LattePandaTeam/LattePanda-Mu-Ultra/Electricals/README.md

# Electronic Design Resources

## Files

- Examples: official carrier board projects

- Libraries: Symbol and footprint libraries for LattePanda Mu Ultra

- Pinouts: All pin definitions for LattePanda Mu Ultra
