LattePandaTeam/LattePanda-Mu-Ultra/Electricals/Examples/README.md

# Sample Projects

LattePanda Mu / Mu Ultra carrier board sample projects for engineers' reference, designed with KiCAD. Please open with KiCAD version 9.0 or higher.

## Official Carrier Board Projects

The official carrier board examples for the LattePanda Mu Ultra are shared with those for the LattePanda Mu. 

Please visit: 👉 [**LattePanda-Mu/Examples**](https://github.com/LattePandaTeam/LattePanda-Mu/tree/main/Electricals/Examples)
