LattePandaTeam/LattePanda-Mu-Ultra/Electricals/Pinouts/LattePanda_Mu_and_Mu_Ultra_Pinout_Comparison.xlsx

Sheet: Overview
 | This document compares the edge connector pins of the LattePanda Mu and LattePanda Mu Ultra to facilitate migration evaluation for your carrier board design.
 | 1. The pin definitions of the LattePanda Mu and LattePanda Mu Ultra are slightly different, and we have used color coding to make it easier for you to compare and evaluate them.
Pin Color Coding Legend
Colour | Note
 | Green (Fully Compatible): Matching voltage level and pin function.
 | Light Green (Conditionally Compatible): Matching voltage level; Pin function varies based on pin muxing or default BIOS config.
 | White (Modified Specification): Changes in pin function or voltage level, within safe limits.
 | Yellow (High Risk): Voltage level mismatch; requires special attention and procedures to prevent pin damage!
 | Special attention and procesures must be paid to Yellow-highlighted pins when designing custom carrier boards!
 | 2. The multiplexing and bifurcation of the high-speed ports on the LattePanda Mu and LattePanda Mu Ultra are different, as shown in the following two figures.
LattePanda Mu |  |  |  |  | LattePanda Mu Ultra
 | 3. The following USB 2.0 ports are bound to TCP ports in the default BIOS firmware.
 | LattePanda Mu |  |  | LattePanda Mu Ultra
 | Pin No. | Signal Name | Note | Pin No. | Signal Name | Note
 | 112 | USB2_P6_P (TCP1) | Must be used with TCP1; cannot be used as generic USB 2.0 | 112 | USB2_P2_P (TCP0) | can be used as generic USB 2.0
 | 114 | USB2_P6_N (TCP1) |  | 114 | USB2_P2_N (TCP0)
 |  |  |  | 109 | USB2_P1_N (TCP1) | can be used as generic USB 2.0
 |  |  |  | 111 | USB2_P1_P (TCP1)
 | 4. If you are using an M.2 CNVio wireless module(e.g. Intel AX211), you must use the USB2_P6 port for Bluetooth. USB2_P6 can also be used as a general-purpose USB 2.0 port.
 |  |  |  | LattePanda Mu Ultra
 |  |  |  | Pin No. | Signal Name
 |  |  |  | 82 | USB2_P6_P (BT)
 |  |  |  | 84 | USB2_P6_N (BT)

Sheet: Front
Pin | LattePana Mu |  |  | LattePanda Mu Ultra
 | Signal Name | Direction | IO Level | Signal Name | Direction | IO Level
1 | PWR_SW# | I | 3.3V | PWR_SW# | I | 3.3V
3 | RST_SW# | I | 3.3V | RST_SW# | I | 3.3V
5 | PSON | O | 3.3V | SLP_S0_S3 | O | 3.3V
7 | SLP_S4 | O | 3.3V | SLP_S4 | O | 3.3V
9 | TSENSE | I | 3.3V | TSENSE | I | 3.3V
11 | GND | PWR | 0V | GND | PWR | 0V
13 | HSIO0_TX_P | O | 0.8V | USB3_P1_TX_P | O | 0.8V
15 | HSIO0_TX_N | O | 0.8V | USB3_P1_TX_N | O | 0.8V
17 | GND | PWR | 0V | GND | PWR | 0V
19 | HSIO1_TX_P | O | 0.8V | USB3_P2_TX_P | O | 0.8V
21 | HSIO1_TX_N | O | 0.8V | USB3_P2_TX_N | O | 0.8V
23 | GND | PWR | 0V | GND | PWR | 0V
25 | HSIO2_TX_P | O | 0.8V | PCIE_TX3_P | O | 0.8V
27 | HSIO2_TX_N | O | 0.8V | PCIE_TX3_N | O | 0.8V
29 | GND | PWR | 0V | GND | PWR | 0V
31 | HSIO3_TX_P | O | 0.8V | PCIE_TX4_P | O | 0.8V
33 | HSIO3_TX_N | O | 0.8V | PCIE_TX4_N | O | 0.8V
35 | GND | PWR | 0V | GND | PWR | 0V
37 | HSIO8_TX_P | O | 0.8V | PCIE_TX5_P | O | 0.8V
39 | HSIO8_TX_N | O | 0.8V | PCIE_TX5_N | O | 0.8V
41 | GND | PWR | 0V | GND | PWR | 0V
43 | HSIO9_TX_P | O | 0.8V | PCIE_TX6_P | O | 0.8V
45 | HSIO9_TX_N | O | 0.8V | PCIE_TX6_N | O | 0.8V
47 | GND | PWR | 0V | GND | PWR | 0V
49 | HSIO10_TX_P | O | 0.8V | PCIE_TX7_P | O | 0.8V
51 | HSIO10_TX_N | O | 0.8V | PCIE_TX7_N | O | 0.8V
53 | GND | PWR | 0V | GND | PWR | 0V
55 | HSIO11_TX_P | O | 0.8V | PCIE_TX8_P | O | 0.8V
57 | HSIO11_TX_N | O | 0.8V | PCIE_TX8_N | O | 0.8V
59 | GND | PWR | 0V | GND | PWR | 0V
61 | HSIO6_TX_P | O | 0.8V | PCIE_TX1_P | O | 0.8V
63 | HSIO6_TX_N | O | 0.8V | PCIE_TX1_N | O | 0.8V
65 | GND | PWR | 0V | GND | PWR | 0V
67 | USB2_P1_N | I/O | 3.3V | PCIE_TX2_P | O | 0.8V
69 | USB2_P1_P | I/O | 3.3V | PCIE_TX2_N | O | 0.8V
71 | GND | PWR | 0V | GND | PWR | 0V
73 | USB2_P2_N | I/O | 3.3V | USB2_P3_N | I/O | 3.3V
75 | USB2_P2_P | I/O | 3.3V | USB2_P3_P | I/O | 3.3V
77 | GND | PWR | 0V | GND | PWR | 0V
79 | USB2_P3_N | I/O | 3.3V | USB2_P4_N | I/O | 3.3V
81 | USB2_P3_P | I/O | 3.3V | USB2_P4_P | I/O | 3.3V
83 | GND | PWR | 0V | GND | PWR | 0V
85 | REFCLK0_P | O | 0.8V | REFCLK0_P | O | 0.8V
87 | REFCLK0_N | O | 0.8V | REFCLK0_N | O | 0.8V
89 | GND | PWR | 0V | GND | PWR | 0V
91 | REFCLK1_P | O | 0.8V | REFCLK1_P | O | 0.8V
93 | REFCLK1_N | O | 0.8V | REFCLK1_N | O | 0.8V
95 | GND | PWR | 0V | GND | PWR | 0V
97 | REFCLK2_P | O | 0.8V | REFCLK2_P | O | 0.8V
99 | REFCLK2_N | O | 0.8V | REFCLK2_N | O | 0.8V
101 | GND | PWR | 0V | GND | PWR | 0V
103 | PCIE_WAKE# | I | 3.3V | PCIE_WAKE# | I | 3.3V
105 | PLT_RST# | O | 3.3V | PLT_RST# | O | 3.3V
107 | GND | PWR | 0V | GND | PWR | 0V
109 | USB2_P5_N | I/O | 3.3V | USB2_P1_N (TCP1) | I/O | 3.3V
111 | USB2_P5_P | I/O | 3.3V | USB2_P1_P (TCP1) | I/O | 3.3V
113 | GND | PWR | 0V | GND | PWR | 0V
115 | VBAT | PWR | 3.0V | VBAT | PWR | 3.0V
117 | PROCHOT# | I | 3.3V | PROCHOT# | I | 3.3V
119 | GPP_E0 | I/O | 3.3V | GPP_E22 (8851_INT) | I/O | 1.8V
121 | GPP_A12 | I/O | 3.3V | CRF_CLKREQ | O | 1.8V
123 | SATA_LED# | O | 3.3V | CNV_RF_RESET# | I/O | 1.8V
125 | PMCALERT# | I | 3.3V | PMCALERT# | I | 3.3V
127 | TPM_IRQ | I | 3.3V | TPM_IRQ | I | 1.8V
129 | USB_OC# | I | 3.3V | USB_OC# | I | 3.3V
131 | SUSCLK | O | 3.3V | SUSCLK | O | 1.8V
133 | BIOS_SEL | I | 3.3V | BIOS_SEL# | I | 3.3V
135 | GND | PWR | 0V | GND | PWR | 0V
137 | UART0_RXD / GPP_H10 | I/O | 3.3V | UART0_RXD / GPP_H08 | I/O | 1.8V
139 | UART0_TXD / GPP_H11 | I/O | 3.3V | UART0_TXD / GPP_H09 | I/O | 1.8V
141 | UART1_RXD / GPP_D17 | I/O | 3.3V | UART1_RXD / GPP_H06 | I/O | 1.8V
143 | UART1_TXD / GPP_D18 | I/O | 3.3V | UART1_TXD / GPP_H07 | I/O | 1.8V
KEY
145 | SML1_DATA | I/O | 3.3V | SML1_DATA | I/O | 3.3V
147 | SML1_CLK | O | 3.3V | SML1_CLK | O | 3.3V
149 | SML1_ALERT# | I | 3.3V | RSVD | / | /
151 | GND | PWR | 0V | GND | PWR | 0V
153 | SPI_IO3 | I/O | 3.3V | SPI_IO3 | I/O | 1.8V
155 | SPI_CLK | O | 3.3V | SPI_CLK | O | 1.8V
157 | SPI_CS2# | O | 3.3V | TPM_SPI_CS# | O | 1.8V
159 | SPI_MOSI/SPI_IO0 | I/O | 3.3V | SPI_MOSI/SPI_IO0 | I/O | 1.8V
161 | SPI_IO2 | I/O | 3.3V | SPI_IO2 | I/O | 1.8V
163 | SPI_MISO/SPI_IO1 | I/O | 3.3V | SPI_MISO/SPI_IO1 | I/O | 1.8V
165 | SPI_CS# | O | 3.3V | FLASH_SPI_CS# | O | 1.8V
167 | GND | PWR | 0V | GND | PWR | 0V
169 | DDIB_CTRL_DATA | I/O | 3.3V | TCP2_CTRL_DATA | I/O | 3.3V
171 | DDIB_CTRL_CLK | O | 3.3V | TCP2_CTRL_CLK | O | 3.3V
173 | TCP1_CTRL_DATA | I/O | 3.3V | TCP1_CTRL_DATA | I/O | 3.3V
175 | TCP1_CTRL_CLK | O | 3.3V | TCP1_CTRL_CLK | O | 3.3V
177 | TCP0_CTRL_DATA | I/O | 3.3V | TCP0_CTRL_DATA | I/O | 3.3V
179 | TCP0_CTRL_CLK | O | 3.3V | TCP0_CTRL_CLK | O | 3.3V
181 | GND | PWR | 0V | GND | PWR | 0V
183 | DDIB_HPD | I | 3.3V | TCP2_HPD | I | 3.3V
185 | TCP1_HPD | I | 3.3V | TCP1_HPD | I | 3.3V
187 | TCP0_HPD | I | 3.3V | TCP0_HPD | I | 3.3V
189 | GND | PWR | 0V | GND | PWR | 0V
191 | DDIB_AUX_N | I/O | 0.6V | TCP2_AUX_N | I/O | 0.6V
193 | DDIB_AUX_P | I/O | 0.6V | TCP2_AUX_P | I/O | 0.6V
195 | GND | PWR | 0V | GND | PWR | 0V
197 | DDIB_TX3_N | O | 1.2V | TCP2_TXRX1_N | I/O | 1.2V
199 | DDIB_TX3_P | O | 1.2V | TCP2_TXRX1_P | I/O | 1.2V
201 | GND | PWR | 0V | GND | PWR | 0V
203 | DDIB_TX2_N | O | 1.2V | TCP2_TX1_N | O | 1.2V
205 | DDIB_TX2_P | O | 1.2V | TCP2_TX1_P | O | 1.2V
207 | GND | PWR | 0V | GND | PWR | 0V
209 | DDIB_TX1_N | O | 1.2V | TCP2_TXRX0_N | I/O | 1.2V
211 | DDIB_TX1_P | O | 1.2V | TCP2_TXRX0_P | I/O | 1.2V
213 | GND | PWR | 0V | GND | PWR | 0V
215 | DDIB_TX0_N | O | 1.2V | TCP2_TX0_N | O | 1.2V
217 | DDIB_TX0_P | O | 1.2V | TCP2_TX0_P | O | 1.2V
219 | GND | PWR | 0V | GND | PWR | 0V
221 | TCP0_AUX_N | I/O | 0.6V | TCP0_AUX_N | I/O | 0.6V
223 | TCP0_AUX_P | I/O | 0.6V | TCP0_AUX_P | I/O | 0.6V
225 | GND | PWR | 0V | GND | PWR | 0V
227 | TCP0_TXRX1_N | I/O | 1.2V | TCP0_TXRX1_N | I/O | 1.2V
229 | TCP0_TXRX1_P | I/O | 1.2V | TCP0_TXRX1_P | I/O | 1.2V
231 | GND | PWR | 0V | GND | PWR | 0V
233 | TCP0_TX1_N | O | 1.2V | TCP0_TX1_N | O | 1.2V
235 | TCP0_TX1_P | O | 1.2V | TCP0_TX1_P | O | 1.2V
237 | GND | PWR | 0V | GND | PWR | 0V
239 | TCP0_TXRX0_N | I/O | 1.2V | TCP0_TXRX0_N | I/O | 1.2V
241 | TCP0_TXRX0_P | I/O | 1.2V | TCP0_TXRX0_P | I/O | 1.2V
243 | GND | PWR | 0V | GND | PWR | 0V
245 | TCP0_TX0_N | O | 1.2V | TCP0_TX0_N | O | 1.2V
247 | TCP0_TX0_P | O | 1.2V | TCP0_TX0_P | O | 1.2V
249 | GND | PWR | 0V | GND | PWR | 0V
251 | VIN | PWR | 9V ~ 20V | VIN | PWR | 9V ~ 20V
253 | VIN | PWR | 9V ~ 20V | VIN | PWR | 9V ~ 20V
255 | VIN | PWR | 9V ~ 20V | VIN | PWR | 9V ~ 20V
257 | VIN | PWR | 9V ~ 20V | VIN | PWR | 9V ~ 20V
259 | VIN | PWR | 9V ~ 20V | VIN | PWR | 9V ~ 20V

Sheet: Back
Pin | LattePana Mu |  |  | LattePanda Mu Ultra
 | Signal Name | Direction | IO Level | Signal Name | Direction | IO Level
2 | FAN2_CTL | O | 3.3V | FAN2_CTL | O | 3.3V
4 | FAN2_TAC | I | 5V | FAN2_TAC | I | 5V
6 | FAN3_CTL | O | 3.3V | FAN3_CTL | O | 3.3V
8 | FAN3_TAC | I | 5V | FAN3_TAC | I | 5V
10 | SIO_UART_TX | O | 3.3V | SIO_UART_TX | O | 3.3V
12 | SIO_UART_RX | I | 3.3V | SIO_UART_RX | I | 3.3V
14 | GND | PWR | 0V | GND | PWR | 0V
16 | HSIO0_RX_P | I | 0.8V | USB3_P1_RX_P | I | 0.8V
18 | HSIO0_RX_N | I | 0.8V | USB3_P1_RX_N | I | 0.8V
20 | GND | PWR | 0V | GND | PWR | 0V
22 | HSIO1_RX_P | I | 0.8V | USB3_P2_RX_P | I | 0.8V
24 | HSIO1_RX_N | I | 0.8V | USB3_P2_RX_N | I | 0.8V
26 | GND | PWR | 0V | GND | PWR | 0V
28 | HSIO2_RX_P | I | 0.8V | PCIE_RX3_P | I | 0.8V
30 | HSIO2_RX_N | I | 0.8V | PCIE_RX3_N | I | 0.8V
32 | GND | PWR | 0V | GND | PWR | 0V
34 | HSIO3_RX_P | I | 0.8V | PCIE_RX4_P | I | 0.8V
36 | HSIO3_RX_N | I | 0.8V | PCIE_RX4_N | I | 0.8V
38 | GND | PWR | 0V | GND | PWR | 0V
40 | HSIO8_RX_P | I | 0.8V | PCIE_RX5_P | I | 0.8V
42 | HSIO8_RX_N | I | 0.8V | PCIE_RX5_N | I | 0.8V
44 | GND | PWR | 0V | GND | PWR | 0V
46 | HSIO9_RX_P | I | 0.8V | PCIE_RX6_P | I | 0.8V
48 | HSIO9_RX_N | I | 0.8V | PCIE_RX6_N | I | 0.8V
50 | GND | PWR | 0V | GND | PWR | 0V
52 | HSIO10_RX_P | I | 0.8V | PCIE_RX7_P | I | 0.8V
54 | HSIO10_RX_N | I | 0.8V | PCIE_RX7_N | I | 0.8V
56 | GND | PWR | 0V | GND | PWR | 0V
58 | HSIO11_RX_P | I | 0.8V | PCIE_RX8_P | I | 0.8V
60 | HSIO11_RX_N | I | 0.8V | PCIE_RX8_N | I | 0.8V
62 | GND | PWR | 0V | GND | PWR | 0V
64 | HSIO6_RX_P | I | 0.8V | PCIE_RX1_P | I | 0.8V
66 | HSIO6_RX_N | I | 0.8V | PCIE_RX1_N | I | 0.8V
68 | GND | PWR | 0V | GND | PWR | 0V
70 | USB2_P4_P | I/O | 3.3V | PCIE_RX2_P | I | 0.8V
72 | USB2_P4_N | I/O | 3.3V | PCIE_RX2_N | I | 0.8V
74 | GND | PWR | 0V | GND | PWR | 0V
76 | USB2_P7_P | I/O | 3.3V | USB2_P5_P | I/O | 3.3V
78 | USB2_P7_N | I/O | 3.3V | USB2_P5_N | I/O | 3.3V
80 | GND | PWR | 0V | GND | PWR | 0V
82 | USB2_P8_P | I/O | 3.3V | USB2_P6_P (BT) | I/O | 3.3V
84 | USB2_P8_N | I/O | 3.3V | USB2_P6_N (BT) | I/O | 3.3V
86 | GND | PWR | 0V | GND | PWR | 0V
88 | REFCLK3_P | O | 0.8V | REFCLK3_P | O | 0.8V
90 | REFCLK3_N | O | 0.8V | REFCLK3_N | O | 0.8V
92 | GND | PWR | 0V | GND | PWR | 0V
94 | REFCLK4_P | O | 0.8V | REFCLK4_P | O | 0.8V
96 | REFCLK4_N | O | 0.8V | REFCLK4_N | O | 0.8V
98 | GND | PWR | 0V | GND | PWR | 0V
100 | REFCLK_REQ3# | I | 3.3V | REFCLK_REQ3# | I | 3.3V
102 | REFCLK_REQ4# | I | 3.3V | REFCLK_REQ4# | I | 3.3V
104 | SMB_ALERT# | I | 3.3V | REFCLK_REQ0# | I | 3.3V
106 | SMB_CLK | O | 3.3V | REFCLK_REQ1# | I | 3.3V
108 | SMB_DATA | I/O | 3.3V | REFCLK_REQ2# | I | 3.3V
110 | GND | PWR | 0V | GND | PWR | 0V
112 | USB2_P6_P (TCP1) | I/O | 3.3V | USB2_P2_P (TCP0) | I/O | 3.3V
114 | USB2_P6_N (TCP1) | I/O | 3.3V | USB2_P2_N (TCP0) | I/O | 3.3V
116 | GND | PWR | 0V | GND | PWR | 0V
118 | GPP_F16 | I/O | 3.3V | GPP_E11 | I/O | 1.8V
120 | GPP_F15 | I/O | 3.3V | GPP_E14 | I/O | 1.8V
122 | GPP_F14 | I/O | 3.3V | GPP_E13 | I/O | 1.8V
124 | GPP_F13 | I/O | 3.3V | GPP_E17 | I/O | 1.8V
126 | GPP_F12 | I/O | 3.3V | GPP_E12 | I/O | 1.8V
128 | GPP_D0 | I/O | 3.3V | GPP_B04 | I/O | 1.8V
130 | GPP_D1 | I/O | 3.3V | GPP_B05 (8851_INT) | I/O | 1.8V
132 | GPP_D2 (8851_INT) | I/O | 3.3V | GPP_B06 | I/O | 1.8V
134 | GPP_D3 | I/O | 3.3V | GPP_B07 (BLINK) | I/O | 1.8V
136 | GND | PWR | 0V | RSVD | / | /
138 | SOC_UART2_TXD / GPP_F2 | I/O | 3.3V | CNV_RGI_DT | O | 1.8V
140 | SOC_UART2_RXD / GPP_F1 | I/O | 3.3V | CNV_BRI_RSP | I | 1.8V
142 | I2C5_SCL | O | 3.3V | CNV_BRI_DT | O | 1.8V
144 | I2C5_SDA | I/O | 3.3V | CNV_RGI_RSP | I | 1.8V
KEY
146 | I2C4_SCL | O | 3.3V | I2C3_SCL | O | 1.8V
148 | I2C4_SDA | I/O | 3.3V | I2C3_SDA | I/O | 1.8V
150 | I2C3_SCL | O | 3.3V | I2C2_SCL | O | 1.8V
152 | I2C3_SDA | I/O | 3.3V | I2C2_SDA | I/O | 1.8V
154 | I2C2_SCL (8851_I2C) | O | 3.3V | I2C1_SCL (8851_I2C) | O | 1.8V
156 | I2C2_SDA (8851_I2C) | I/O | 3.3V | I2C1_SDA (8851_I2C) | I/O | 1.8V
158 | GND | PWR | 0V | GND | PWR | 0V
160 | I2S_MCLK | O | 1.8V | RSVD | / | /
162 | I2S_SCLK | O | 1.8V | RSVD | / | /
164 | I2S_SFRM | O | 1.8V | RSVD | / | /
166 | I2S_TXD | O | 1.8V | RSVD | / | /
168 | I2S_RXD | I | 1.8V | RSVD | / | /
170 | GND | PWR | 0V | GND | PWR | 0V
172 | HDA_RST | O | 3.3V | HDA_RST# | O | 1.8V
174 | HDA_BCLK | O | 3.3V | HDA_BCLK | O | 1.8V
176 | HDA_SYNC | O | 3.3V | HDA_SYNC | O | 1.8V
178 | HDA_SDOUT | O | 3.3V | HDA_SDO | O | 1.8V
180 | HDA_SDIN | I | 3.3V | HDA_SDI0 | I | 1.8V
182 | GND | PWR | 0V | GND | PWR | 0V
184 | CSI_D_CK_P | I | 1.26V | CNV_WT_CLK_P | O | 1.2V
186 | CSI_D_CK_N | I | 1.26V | CNV_WT_CLK_N | O | 1.2V
188 | GND | PWR | 0V | GND | PWR | 0V
190 | CSI_D_D1_P | I | 1.26V | CNV_WT_D0_P | O | 1.2V
192 | CSI_D_D1_N | I | 1.26V | CNV_WT_D0_N | O | 1.2V
194 | GND | PWR | 0V | GND | PWR | 0V
196 | CSI_D_D0_P | I | 1.26V | CNV_WT_D1_P | O | 1.2V
198 | CSI_D_D0_N | I | 1.26V | CNV_WT_D1_N | O | 1.2V
200 | GND | PWR | 0V | GND | PWR | 0V
202 | CSI_C_CK_P | I | 1.26V | CNV_WR_CLK_P | I | 1.2V
204 | CSI_C_CK_N | I | 1.26V | CNV_WR_CLK_N | I | 1.2V
206 | GND | PWR | 0V | GND | PWR | 0V
208 | CSI_C_D1_P | I | 1.26V | CNV_WR_D0_P | I | 1.2V
210 | CSI_C_D1_N | I | 1.26V | CNV_WR_D0_N | I | 1.2V
212 | GND | PWR | 0V | GND | PWR | 0V
214 | CSI_C_D0_P | I | 1.26V | CNV_WR_D1_P | I | 1.2V
216 | CSI_C_D0_N | I | 1.26V | CNV_WR_D1_N | I | 1.2V
218 | GND | PWR | 0V | GND | PWR | 0V
220 | TCP1_TX0_P | O | 1.2V | TCP1_TX0_P | O | 1.2V
222 | TCP1_TX0_N | O | 1.2V | TCP1_TX0_N | O | 1.2V
224 | GND | PWR | 0V | GND | PWR | 0V
226 | TCP1_TXRX0_P | I/O | 1.2V | TCP1_TXRX0_P | I/O | 1.2V
228 | TCP1_TXRX0_N | I/O | 1.2V | TCP1_TXRX0_N | I/O | 1.2V
230 | GND | PWR | 0V | GND | PWR | 0V
232 | TCP1_TX1_P | O | 1.2V | TCP1_TX1_P | O | 1.2V
234 | TCP1_TX1_N | O | 1.2V | TCP1_TX1_N | O | 1.2V
236 | GND | PWR | 0V | GND | PWR | 0V
238 | TCP1_TXRX1_P | I/O | 1.2V | TCP1_TXRX1_P | I/O | 1.2V
240 | TCP1_TXRX1_N | I/O | 1.2V | TCP1_TXRX1_N | I/O | 1.2V
242 | GND | PWR | 0V | GND | PWR | 0V
244 | TCP1_AUX_P | I/O | 0.6V | TCP1_AUX_P | I/O | 0.6V
246 | TCP1_AUX_N | I/O | 0.6V | TCP1_AUX_N | I/O | 0.6V
248 | GND | PWR | 0V | GND | PWR | 0V
250 | VIN | PWR | 9V ~ 20V | VIN | PWR | 9V ~ 20V
252 | VIN | PWR | 9V ~ 20V | VIN | PWR | 9V ~ 20V
254 | VIN | PWR | 9V ~ 20V | VIN | PWR | 9V ~ 20V
256 | VIN | PWR | 9V ~ 20V | VIN | PWR | 9V ~ 20V
258 | VIN | PWR | 9V ~ 20V | VIN | PWR | 9V ~ 20V
260 | VIN | PWR | 9V ~ 20V | VIN | PWR | 9V ~ 20V
