LattePandaTeam/LattePanda-Mu-Ultra/Electricals/Pinouts/LattePanda_Mu_Ultra_Edge_Connector_Pinout.xlsx

Sheet: Overview
Speed: Indicates the operating speed of the signal pin. "Low" denotes low-speed signals requiring only standard PCB routing. "High" denotes high-speed signals which mandate impedance matching in the PCB design.
IO Level: For multiplexed pins, the IO voltage level may vary depending on the configured function. This document specifies the maximum voltage supported by the pin.
Note:
This document is applicable only to LattePanda Mu Ultra compute modules equipped with Intel Core Ultra 2 Series processor(Lunar Lake).
Due to the various PCIe bifurcation, please consult the BIOS functionality documentation before beginning your design:
https://github.com/LattePandaTeam/LattePanda-Mu-Ultra/tree/main/Softwares/BIOS
Pinout Description Page
https://github.com/LattePandaTeam/LattePanda-Mu-Ultra/tree/main/Electricals/Pinouts

Sheet: Front
Pin | Signal Name | Direction | IO Level | Description | Speed | Notes
1 | PWR_SW# | I | 3.3V | System Power Switch | Low | Active LOW; Internally 10K Pulled Up
3 | RST_SW# | I | 3.3V | System Reset Switch | Low | Active LOW; Internally 10K Pulled Up
5 | SLP_S0_S3 | O | 3.3V | System Status | Low | Output HIGH only when Working and Modern Standby; 4.7K Pulled-up(Weak Drive of HIGH output)
7 | SLP_S4 | O | 3.3V | System Status | Low | Output HIGH only when Working and Modern Standby; 4.7K Pulled-up(Weak Drive of HIGH output)
9 | TSENSE | I | 3.3V | NTC Temperature Sensor | Low
11 | GND | PWR | 0V | Ground | /
13 | USB3_P1_TX_P | O | 0.8V | USB 3.2 Port 1 TX Differential Pair | High | External AC Coupling Capacitor Required
15 | USB3_P1_TX_N | O | 0.8V | USB 3.2 Port 1 TX Differential Pair | High | External AC Coupling Capacitor Required
17 | GND | PWR | 0V | Ground | /
19 | USB3_P2_TX_P | O | 0.8V | USB 3.2 Port 2 TX Differential Pair | High | External AC Coupling Capacitor Required
21 | USB3_P2_TX_N | O | 0.8V | USB 3.2 Port 2 TX Differential Pair | High | External AC Coupling Capacitor Required
23 | GND | PWR | 0V | Ground | /
25 | PCIE_TX3_P | O | 0.8V | PCIe Lane 3 TX Differential Pair | High | External AC Coupling Capacitor Required
27 | PCIE_TX3_N | O | 0.8V | PCIe Lane 3 TX Differential Pair | High | External AC Coupling Capacitor Required
29 | GND | PWR | 0V | Ground | /
31 | PCIE_TX4_P | O | 0.8V | PCIe Lane 4 TX Differential Pair | High | External AC Coupling Capacitor Required
33 | PCIE_TX4_N | O | 0.8V | PCIe Lane 4 TX Differential Pair | High | External AC Coupling Capacitor Required
35 | GND | PWR | 0V | Ground | /
37 | PCIE_TX5_P | O | 0.8V | PCIe Lane 5 TX Differential Pair | High | External AC Coupling Capacitor Required
39 | PCIE_TX5_N | O | 0.8V | PCIe Lane 5 TX Differential Pair | High | External AC Coupling Capacitor Required
41 | GND | PWR | 0V | Ground | /
43 | PCIE_TX6_P | O | 0.8V | PCIe Lane 6 TX Differential Pair | High | External AC Coupling Capacitor Required
45 | PCIE_TX6_N | O | 0.8V | PCIe Lane 6 TX Differential Pair | High | External AC Coupling Capacitor Required
47 | GND | PWR | 0V | Ground | /
49 | PCIE_TX7_P | O | 0.8V | PCIe Lane 7 TX Differential Pair | High | External AC Coupling Capacitor Required
51 | PCIE_TX7_N | O | 0.8V | PCIe Lane 7 TX Differential Pair | High | External AC Coupling Capacitor Required
53 | GND | PWR | 0V | Ground | /
55 | PCIE_TX8_P | O | 0.8V | PCIe Lane 8 TX Differential Pair | High | External AC Coupling Capacitor Required
57 | PCIE_TX8_N | O | 0.8V | PCIe Lane 8 TX Differential Pair | High | External AC Coupling Capacitor Required
59 | GND | PWR | 0V | Ground | /
61 | PCIE_TX1_P | O | 0.8V | PCIe Lane 1 TX Differential Pair | High | External AC Coupling Capacitor Required
63 | PCIE_TX1_N | O | 0.8V | PCIe Lane 1 TX Differential Pair | High | External AC Coupling Capacitor Required
65 | GND | PWR | 0V | Ground | /
67 | PCIE_TX2_P | O | 0.8V | PCIe Lane 2 TX Differential Pair | High | Integrated 220nF AC Coupling Capacitor
69 | PCIE_TX2_N | O | 0.8V | PCIe Lane 2 TX Differential Pair | High | Integrated 220nF AC Coupling Capacitor
71 | GND | PWR | 0V | Ground | /
73 | USB2_P3_N | I/O | 3.3V | USB 2.0 Port 3 Differential Pair | High
75 | USB2_P3_P | I/O | 3.3V | USB 2.0 Port 3 Differential Pair | High
77 | GND | PWR | 0V | Ground | /
79 | USB2_P4_N | I/O | 3.3V | USB 2.0 Port 4 Differential Pair | High
81 | USB2_P4_P | I/O | 3.3V | USB 2.0 Port 4 Differential Pair | High
83 | GND | PWR | 0V | Ground | /
85 | REFCLK0_P | O | 0.8V | PCIe Reference Clock 0 Differential Pair | High | 100MHz
87 | REFCLK0_N | O | 0.8V | PCIe Reference Clock 0 Differential Pair | High | 100MHz
89 | GND | PWR | 0V | Ground | /
91 | REFCLK1_P | O | 0.8V | PCIe Reference Clock 1 Differential Pair | High | 100MHz
93 | REFCLK1_N | O | 0.8V | PCIe Reference Clock 1 Differential Pair | High | 100MHz
95 | GND | PWR | 0V | Ground | /
97 | REFCLK2_P | O | 0.8V | PCIe Reference Clock 2 Differential Pair | High | 100MHz
99 | REFCLK2_N | O | 0.8V | PCIe Reference Clock 2 Differential Pair | High | 100MHz
101 | GND | PWR | 0V | Ground | /
103 | PCIE_WAKE# | I | 3.3V | PCIe Wake Request | Low | Pulled LOW to Wake System; Internally 10K Pulled Up
105 | PLT_RST# | O | 3.3V | Platform Reset for PCIe | Low | Output LOW to Reset PCIe Device
107 | GND | PWR | 0V | Ground | /
109 | USB2_P1_N | I/O | 3.3V | USB 2.0 Port 1 Differential Pair | High | Bound to TCP1 in Default BIOS
111 | USB2_P1_P | I/O | 3.3V | USB 2.0 Port 1 Differential Pair | High | Bound to TCP1 in Default BIOS
113 | GND | PWR | 0V | Ground | /
115 | VBAT | PWR | 3.0V | RTC Battery Input | /
117 | PROCHOT# | I | 3.3V | (TCC) Overheat Protect | Low | Active LOW; Internally 10K Pulled Up
119 | GPP_E22 | I/O | 1.8V | GPIO | Low | BIOS Default Function: IT8851_INT
121 | CRF_CLKREQ | O | 1.8V | CNVi SOC to CRF Wake Indication | Low
123 | CNV_RF_RESET# | I/O | 1.8V | CNVi RF Companion (CRF) Reset Signal | Low | Active Low
125 | PMCALERT# | I | 3.3V | USB Type-C PD Controller / Re-timer Alert | Low | Active LOW; Internally 10K Pulled Up
127 | TPM_IRQ | I | 1.8V | Discrete TPM Interrupt | Low | Internally 4.7K Pulled Up
129 | USB_OC# | I | 3.3V | USB Over Current | Low | Active LOW; Internally 10K Pulled Up
131 | SUSCLK | O | 1.8V | Suspend Clock | Low | 32.768KHz
133 | BIOS_SEL# | I | 3.3V | BIOS ROM Select | Low | Internally 100K Pulled Up; HIGH: Integrated ROM; LOW: Carrier ROM
135 | GND | PWR | 0V | Ground | /
137 | UART0_RXD / GPP_H08 | I/O | 1.8V | SoC UART0 RX / GPIO | Low | BIOS Default Function: UART
139 | UART0_TXD / GPP_H09 | I/O | 1.8V | SoC UART0 TX / GPIO | Low | BIOS Default Function: UART
141 | UART1_RXD / GPP_H06 | I/O | 1.8V | SoC UART1 RX / GPIO | Low | BIOS Default Function: UART
143 | UART1_TXD / GPP_H07 | I/O | 1.8V | SoC UART1 TX / GPIO | Low | BIOS Default Function: UART
KEY
145 | SML1_DATA | I/O | 3.3V | SMLink1 Data | Low | Internally 2.2K Pulled Up
147 | SML1_CLK | O | 3.3V | SMLink1 Clock | Low | Internally 2.2K Pulled Up
149 | RSVD | / | / | No Connect | /
151 | GND | PWR | 0V | Ground | /
153 | SPI_IO3 | I/O | 1.8V | SPI Bus for BIOS and dTPM | Low
155 | SPI_CLK | O | 1.8V | SPI Bus for BIOS and dTPM | Low
157 | TPM_SPI_CS# | O | 1.8V | SPI Chip Select for dTPM | Low
159 | SPI_MOSI/SPI_IO0 | I/O | 1.8V | SPI Bus for BIOS and dTPM | Low
161 | SPI_IO2 | I/O | 1.8V | SPI Bus for BIOS and dTPM | Low
163 | SPI_MISO/SPI_IO1 | I/O | 1.8V | SPI Bus for BIOS and dTPM | Low
165 | FLASH_SPI_CS# | O | 1.8V | SPI Chip Select for BIOS ROM | Low
167 | GND | PWR | 0V | Ground | /
169 | TCP2_CTRL_DATA | I/O | 3.3V | TCP2 Control Data | Low | Internally 4.7K Pulled Up
171 | TCP2_CTRL_CLK | O | 3.3V | TCP2 Control Clock | Low | Internally 4.7K Pulled Up
173 | TCP1_CTRL_DATA | I/O | 3.3V | TCP1 Control Data | Low | Internally 4.7K Pulled Up
175 | TCP1_CTRL_CLK | O | 3.3V | TCP1 Control Clock | Low | Internally 4.7K Pulled Up
177 | TCP0_CTRL_DATA | I/O | 3.3V | TCP0 Control Data | Low | Internally 4.7K Pulled Up
179 | TCP0_CTRL_CLK | O | 3.3V | TCP0 Control Clock | Low | Internally 4.7K Pulled Up
181 | GND | PWR | 0V | Ground | /
183 | TCP2_HPD | I | 3.3V | TCP2 Hot Plug Detect | Low
185 | TCP1_HPD | I | 3.3V | TCP1 Hot Plug Detect | Low
187 | TCP0_HPD | I | 3.3V | TCP0 Hot Plug Detect | Low
189 | GND | PWR | 0V | Ground | /
191 | TCP2_AUX_N | I/O | 0.6V | TCP2 DP Auxiliary Channel | Low
193 | TCP2_AUX_P | I/O | 0.6V | TCP2 DP Auxiliary Channel | Low
195 | GND | PWR | 0V | Ground | /
197 | TCP2_TXRX1_N | I/O | 1.2V | TCP2 DP Lane 3 / HDMI TMDS Clock / Type C RX Data Lane 2 | High | External AC Coupling Capacitor Required
199 | TCP2_TXRX1_P | I/O | 1.2V | TCP2 DP Lane 3 / HDMI TMDS Clock / Type C RX Data Lane 2 | High | External AC Coupling Capacitor Required
201 | GND | PWR | 0V | Ground | /
203 | TCP2_TX1_N | O | 1.2V | TCP2 DP Lane 2 / HDMI TMDS Data0 / Type C TX Data Lane 2 | High | External AC Coupling Capacitor Required
205 | TCP2_TX1_P | O | 1.2V | TCP2 DP Lane 2 / HDMI TMDS Data0 / Type C TX Data Lane 2 | High | External AC Coupling Capacitor Required
207 | GND | PWR | 0V | Ground | /
209 | TCP2_TXRX0_N | I/O | 1.2V | TCP2 DP Lane 1 / HDMI TMDS Data1 / Type C RX Data Lane 1 | High | External AC Coupling Capacitor Required
211 | TCP2_TXRX0_P | I/O | 1.2V | TCP2 DP Lane 1 / HDMI TMDS Data1 / Type C RX Data Lane 1 | High | External AC Coupling Capacitor Required
213 | GND | PWR | 0V | Ground | /
215 | TCP2_TX0_N | O | 1.2V | TCP2 DP Lane 0 / HDMI TMDS Data2 / Type C TX Data Lane 1 | High | External AC Coupling Capacitor Required
217 | TCP2_TX0_P | O | 1.2V | TCP2 DP Lane 0 / HDMI TMDS Data2 / Type C TX Data Lane 1 | High | External AC Coupling Capacitor Required
219 | GND | PWR | 0V | Ground | /
221 | TCP0_AUX_N | I/O | 0.6V | TCP0 DP Auxiliary Channel | Low
223 | TCP0_AUX_P | I/O | 0.6V | TCP0 DP Auxiliary Channel | Low
225 | GND | PWR | 0V | Ground | /
227 | TCP0_TXRX1_N | I/O | 1.2V | TCP0 DP Lane 3 / HDMI TMDS Clock / Type C RX Data Lane 2 | High | External AC Coupling Capacitor Required
229 | TCP0_TXRX1_P | I/O | 1.2V | TCP0 DP Lane 3 / HDMI TMDS Clock / Type C RX Data Lane 2 | High | External AC Coupling Capacitor Required
231 | GND | PWR | 0V | Ground | /
233 | TCP0_TX1_N | O | 1.2V | TCP0 DP Lane 2 / HDMI TMDS Data0 / Type C TX Data Lane 2 | High | External AC Coupling Capacitor Required
235 | TCP0_TX1_P | O | 1.2V | TCP0 DP Lane 2 / HDMI TMDS Data0 / Type C TX Data Lane 2 | High | External AC Coupling Capacitor Required
237 | GND | PWR | 0V | Ground | /
239 | TCP0_TXRX0_N | I/O | 1.2V | TCP0 DP Lane 1 / HDMI TMDS Data1 / Type C RX Data Lane 1 | High | External AC Coupling Capacitor Required
241 | TCP0_TXRX0_P | I/O | 1.2V | TCP0 DP Lane 1 / HDMI TMDS Data1 / Type C RX Data Lane 1 | High | External AC Coupling Capacitor Required
243 | GND | PWR | 0V | Ground | /
245 | TCP0_TX0_N | O | 1.2V | TCP0 DP Lane 0 / HDMI TMDS Data2 / Type C TX Data Lane 1 | High | External AC Coupling Capacitor Required
247 | TCP0_TX0_P | O | 1.2V | TCP0 DP Lane 0 / HDMI TMDS Data2 / Type C TX Data Lane 1 | High | External AC Coupling Capacitor Required
249 | GND | PWR | 0V | Ground | /
251 | VIN | PWR | 9V ~ 20V | Main Power Input | /
253 | VIN | PWR | 9V ~ 20V | Main Power Input | /
255 | VIN | PWR | 9V ~ 20V | Main Power Input | /
257 | VIN | PWR | 9V ~ 20V | Main Power Input | /
259 | VIN | PWR | 9V ~ 20V | Main Power Input | /

Sheet: Back
Pin | Signal Name | Direction | IO Level | Description | Speed | Notes
2 | FAN2_CTL | O | 3.3V | CPU Fan PWM | Low | Internally 4.7K Pulled Up
4 | FAN2_TAC | I | 5V | CPU Fan Tacho | Low
6 | FAN3_CTL | O | 3.3V | SYS Fan PWM | Low | Internally 4.7K Pulled Up
8 | FAN3_TAC | I | 5V | SYS Fan Tacho | Low
10 | SIO_UART_TX | O | 3.3V | SuperIO UART TX | Low
12 | SIO_UART_RX | I | 3.3V | SuperIO UART RX | Low
14 | GND | PWR | 0V | Ground | /
16 | USB3_P1_RX_P | I | 0.8V | USB 3.2 Port 1 RX Differential Pair | High | External AC Coupling Capacitor Required
18 | USB3_P1_RX_N | I | 0.8V | USB 3.2 Port 1 RX Differential Pair | High | External AC Coupling Capacitor Required
20 | GND | PWR | 0V | Ground | /
22 | USB3_P2_RX_P | I | 0.8V | USB 3.2 Port 2 RX Differential Pair | High | External AC Coupling Capacitor Required
24 | USB3_P2_RX_N | I | 0.8V | USB 3.2 Port 2 RX Differential Pair | High | External AC Coupling Capacitor Required
26 | GND | PWR | 0V | Ground | /
28 | PCIE_RX3_P | I | 0.8V | PCIe Lane 3 RX Differential Pair | High | External AC Coupling Capacitor Required
30 | PCIE_RX3_N | I | 0.8V | PCIe Lane 3 RX Differential Pair | High | External AC Coupling Capacitor Required
32 | GND | PWR | 0V | Ground | /
34 | PCIE_RX4_P | I | 0.8V | PCIe Lane 4 RX Differential Pair | High | External AC Coupling Capacitor Required
36 | PCIE_RX4_N | I | 0.8V | PCIe Lane 4 RX Differential Pair | High | External AC Coupling Capacitor Required
38 | GND | PWR | 0V | Ground | /
40 | PCIE_RX5_P | I | 0.8V | PCIe Lane 5 RX Differential Pair | High | External AC Coupling Capacitor Required
42 | PCIE_RX5_N | I | 0.8V | PCIe Lane 5 RX Differential Pair | High | External AC Coupling Capacitor Required
44 | GND | PWR | 0V | Ground | /
46 | PCIE_RX6_P | I | 0.8V | PCIe Lane 6 RX Differential Pair | High | External AC Coupling Capacitor Required
48 | PCIE_RX6_N | I | 0.8V | PCIe Lane 6 RX Differential Pair | High | External AC Coupling Capacitor Required
50 | GND | PWR | 0V | Ground | /
52 | PCIE_RX7_P | I | 0.8V | PCIe Lane 7 RX Differential Pair | High | External AC Coupling Capacitor Required
54 | PCIE_RX7_N | I | 0.8V | PCIe Lane 7 RX Differential Pair | High | External AC Coupling Capacitor Required
56 | GND | PWR | 0V | Ground | /
58 | PCIE_RX8_P | I | 0.8V | PCIe Lane 8 RX Differential Pair | High | External AC Coupling Capacitor Required
60 | PCIE_RX8_N | I | 0.8V | PCIe Lane 8 RX Differential Pair | High | External AC Coupling Capacitor Required
62 | GND | PWR | 0V | Ground | /
64 | PCIE_RX1_P | I | 0.8V | PCIe Lane 1 RX Differential Pair | High | External AC Coupling Capacitor Required
66 | PCIE_RX1_N | I | 0.8V | PCIe Lane 1 RX Differential Pair | High | External AC Coupling Capacitor Required
68 | GND | PWR | 0V | Ground | /
70 | PCIE_RX2_P | I | 0.8V | PCIe Lane 2 RX Differential Pair | High | Integrated 220nF AC Coupling Capacitor
72 | PCIE_RX2_N | I | 0.8V | PCIe Lane 2 RX Differential Pair | High | Integrated 220nF AC Coupling Capacitor
74 | GND | PWR | 0V | Ground | /
76 | USB2_P5_P | I/O | 3.3V | USB 2.0 Port 5 Differential Pair | High
78 | USB2_P5_N | I/O | 3.3V | USB 2.0 Port 5 Differential Pair | High
80 | GND | PWR | 0V | Ground | /
82 | USB2_P6_P | I/O | 3.3V | USB 2.0 Port 6 Differential Pair | High | Dedicated to BT; can also for generic USB 2.0
84 | USB2_P6_N | I/O | 3.3V | USB 2.0 Port 6 Differential Pair | High | Dedicated to BT; can also for generic USB 2.0
86 | GND | PWR | 0V | Ground | /
88 | REFCLK3_P | O | 0.8V | PCIe Reference Clock 3 Differential Pair | High | 100MHz
90 | REFCLK3_N | O | 0.8V | PCIe Reference Clock 3 Differential Pair | High | 100MHz
92 | GND | PWR | 0V | Ground | /
94 | REFCLK4_P | O | 0.8V | PCIe Reference Clock 4 Differential Pair | High | 100MHz
96 | REFCLK4_N | O | 0.8V | PCIe Reference Clock 4 Differential Pair | High | 100MHz
98 | GND | PWR | 0V | Ground | /
100 | REFCLK_REQ3# | I | 3.3V | Clock Request of REFCLK3 | Low | Active LOW; Internally 10K Pulled Up
102 | REFCLK_REQ4# | I | 3.3V | Clock Request of REFCLK4 | Low | Active LOW; Internally 10K Pulled Up
104 | REFCLK_REQ0# | I | 3.3V | Clock Request of REFCLK0 | Low | Active LOW; Internally 10K Pulled Up
106 | REFCLK_REQ1# | I | 3.3V | Clock Request of REFCLK1 | Low | Active LOW; Internally 10K Pulled Up
108 | REFCLK_REQ2# | I | 3.3V | Clock Request of REFCLK2 | Low | Active LOW; Internally 10K Pulled Up
110 | GND | PWR | 0V | Ground | /
112 | USB2_P2_P | I/O | 3.3V | USB 2.0 Port 2 Differential Pair | High | Bound to TCP0 in Default BIOS
114 | USB2_P2_N | I/O | 3.3V | USB 2.0 Port 2 Differential Pair | High | Bound to TCP0 in Default BIOS
116 | GND | PWR | 0V | Ground | /
118 | GPP_E11 | I/O | 1.8V | GPIO | Low
120 | GPP_E14 | I/O | 1.8V | GPIO | Low
122 | GPP_E13 | I/O | 1.8V | GPIO | Low
124 | GPP_E17 | I/O | 1.8V | GPIO | Low
126 | GPP_E12 | I/O | 1.8V | GPIO | Low
128 | GPP_B04 | I/O | 1.8V | GPIO | Low
130 | GPP_B05 | I/O | 1.8V | GPIO | Low | BIOS Default Function: IT8851_INT
132 | GPP_B06 | I/O | 1.8V | GPIO | Low
134 | GPP_B07 | I/O | 1.8V | GPIO | Low | BIOS Default Function: Modern Standby Blink Output
136 | RSVD | / | / | No Connect | /
138 | CNV_RGI_DT | O | 1.8V | CNVi RGI Bus TX | Low
140 | CNV_BRI_RSP | I | 1.8V | CNVi BRI Bus RX | Low
142 | CNV_BRI_DT | O | 1.8V | CNVi BRI Bus TX | Low
144 | CNV_RGI_RSP | I | 1.8V | CNVi RGI Bus RX | Low
KEY
146 | I2C3_SCL | O | 1.8V | I2C3 Clock | Low | Internally 2.2K Pulled Up
148 | I2C3_SDA | I/O | 1.8V | I2C3 Data | Low | Internally 2.2K Pulled Up
150 | I2C2_SCL | O | 1.8V | I2C2 Clock | Low | Internally 2.2K Pulled Up
152 | I2C2_SDA | I/O | 1.8V | I2C2 Data | Low | Internally 2.2K Pulled Up
154 | I2C1_SCL | O | 1.8V | I2C1 Clock | Low | Internally 2.2K Pulled Up
156 | I2C1_SDA | I/O | 1.8V | I2C1 Data | Low | Internally 2.2K Pulled Up
158 | GND | PWR | 0V | Ground | /
160 | RSVD | / | / | No Connect | /
162 | RSVD | / | / | No Connect | /
164 | RSVD | / | / | No Connect | /
166 | RSVD | / | / | No Connect | /
168 | RSVD | / | / | No Connect | /
170 | GND | PWR | 0V | Ground | /
172 | HDA_RST# | O | 1.8V | HD Audio Reset | Low
174 | HDA_BCLK | O | 1.8V | HD Audio Codec Bit Clock | Low
176 | HDA_SYNC | O | 1.8V | HD Audio Codec Sync | Low
178 | HDA_SDO | O | 1.8V | HD Audio Codec Serial Data Out | Low
180 | HDA_SDI0 | I | 1.8V | HD Audio Codec Serial Data In | Low
182 | GND | PWR | 0V | Ground | /
184 | CNV_WT_CLK_P | O | 1.2V | CNVio Bus TX CLK Differential Pair | High
186 | CNV_WT_CLK_N | O | 1.2V | CNVio Bus TX CLK Differential Pair | High
188 | GND | PWR | 0V | Ground | /
190 | CNV_WT_D0_P | O | 1.2V | CNVio Bus Lane 0 TX Differential Pair | High
192 | CNV_WT_D0_N | O | 1.2V | CNVio Bus Lane 0 TX Differential Pair | High
194 | GND | PWR | 0V | Ground | /
196 | CNV_WT_D1_P | O | 1.2V | CNVio Bus Lane 1 TX Differential Pair | High
198 | CNV_WT_D1_N | O | 1.2V | CNVio Bus Lane 1 TX Differential Pair | High
200 | GND | PWR | 0V | Ground | /
202 | CNV_WR_CLK_P | I | 1.2V | CNVio Bus RX CLK Differential Pair | High
204 | CNV_WR_CLK_N | I | 1.2V | CNVio Bus RX CLK Differential Pair | High
206 | GND | PWR | 0V | Ground | /
208 | CNV_WR_D0_P | I | 1.2V | CNVio Bus Lane 0 RX Differential Pair | High
210 | CNV_WR_D0_N | I | 1.2V | CNVio Bus Lane 0 RX Differential Pair | High
212 | GND | PWR | 0V | Ground | /
214 | CNV_WR_D1_P | I | 1.2V | CNVio Bus Lane 1 RX Differential Pair | High
216 | CNV_WR_D1_N | I | 1.2V | CNVio Bus Lane 1 RX Differential Pair | High
218 | GND | PWR | 0V | Ground | /
220 | TCP1_TX0_P | O | 1.2V | TCP1 DP Lane 0 / HDMI TMDS Data2 / Type C TX Data Lane 1 | High | External AC Coupling Capacitor Required
222 | TCP1_TX0_N | O | 1.2V | TCP1 DP Lane 0 / HDMI TMDS Data2 / Type C TX Data Lane 1 | High | External AC Coupling Capacitor Required
224 | GND | PWR | 0V | Ground | /
226 | TCP1_TXRX0_P | I/O | 1.2V | TCP1 DP Lane 1 / HDMI TMDS Data1 / Type C RX Data Lane 1 | High | External AC Coupling Capacitor Required
228 | TCP1_TXRX0_N | I/O | 1.2V | TCP1 DP Lane 1 / HDMI TMDS Data1 / Type C RX Data Lane 1 | High | External AC Coupling Capacitor Required
230 | GND | PWR | 0V | Ground | /
232 | TCP1_TX1_P | O | 1.2V | TCP1 DP Lane 2 / HDMI TMDS Data0 / Type C TX Data Lane 2 | High | External AC Coupling Capacitor Required
234 | TCP1_TX1_N | O | 1.2V | TCP1 DP Lane 2 / HDMI TMDS Data0 / Type C TX Data Lane 2 | High | External AC Coupling Capacitor Required
236 | GND | PWR | 0V | Ground | /
238 | TCP1_TXRX1_P | I/O | 1.2V | TCP1 DP Lane 3 / HDMI TMDS Clock / Type C RX Data Lane 2 | High | External AC Coupling Capacitor Required
240 | TCP1_TXRX1_N | I/O | 1.2V | TCP1 DP Lane 3 / HDMI TMDS Clock / Type C RX Data Lane 2 | High | External AC Coupling Capacitor Required
242 | GND | PWR | 0V | Ground | /
244 | TCP1_AUX_P | I/O | 0.6V | TCP1 DP Auxiliary Channel | Low
246 | TCP1_AUX_N | I/O | 0.6V | TCP1 DP Auxiliary Channel | Low
248 | GND | PWR | 0V | Ground | /
250 | VIN | PWR | 9V ~ 20V | Main Power Input | /
252 | VIN | PWR | 9V ~ 20V | Main Power Input | /
254 | VIN | PWR | 9V ~ 20V | Main Power Input | /
256 | VIN | PWR | 9V ~ 20V | Main Power Input | /
258 | VIN | PWR | 9V ~ 20V | Main Power Input | /
260 | VIN | PWR | 9V ~ 20V | Main Power Input | /
