LattePandaTeam/LattePanda-Mu-Ultra/Mechanicals/LattePanda Mu Ultra 3D Model.stp

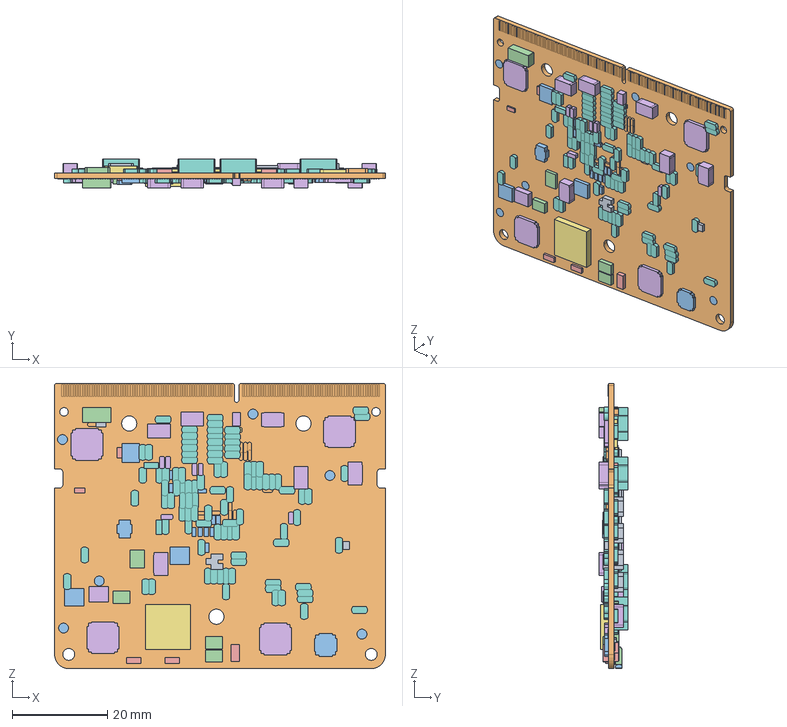
[picture p4: CAD file, 2026-08-21]
Mechanicals/LattePanda Mu Ultra 3D Model.stp
69.6 x 6.20 x 60.0 mm
SBCLNLCXR100-PCB_9_1
0_5FPC_H1_5_6PIN_STP_1_9_1
0_5FPC_H1_5_6PIN_STP_2_9_1
LV0505-401GB_ASM_9_ASM_1_ASM
LV0504-40-0010RA-G3_9_1
CAP_2_3D5X2D8_H1D9_9_1 x 6
DFN8_0D5_2X2_H0D8_T1D6X0D9_9_1
LCC13_P4MM_SQ3MM_P8H_9_1 x 7
R0402_9_1
C0402_9_1 x 6
SMC0402-10UF_9_1 x 10
CAP3528_20_9_1
R0603_9_1 x 2
SOT23-6_9_1
LQFP64_0D4_1D6_9_1
SOIC8_12X30_PAD_9_1
CAP_2_3D5X2D8_H1D4_9_1 x 4
SMI4450X4006_2H_MA_9_1 x 5
SOD-123_9_1
FIDUCIAL_MARK_9_1 x 12
SOT353-5-0D65_9_1 x 5
SOD923-25-CDZ6_9_1 x 2
QFN56_6X6_P0D35_H0D8_9_1 x 4
SOIC8_208_9_1
FB0603_9_1 x 2
SOT723_9_1
QFN13_0D5_2X3_H1D0_NB68X_9_1
SOT23_GDS_9_1 x 3
SMY_4P_3D2X2D5_PAD48X60_0D8H_9_
SOT23_123_9_1
FB0805_9_1
SMC0402_9_1 x 7
SMC0603_9_1 x 6
SMC0201_9_1
C0603_9_1 x 148
SOD523_9_1
SOT563_0D5_1D6X1D2_H0D6_9_1
TQFN28_0D4_4X4_H0D8_T2D6X2D6_9_
TK1_LCC21_3100X5100_400_MA_9_1 x 2
LCC21_P4MM_3X4MM_P8H_9_1 x 3
SOT23-5_9_1
SML_5P7X5P4_1P5H_9_1 x 2
SML_7P0X6P6_3P0H_9_1 x 5
SOT_23_9_1
FC135-3215_9_1
SOT23_5_1P25H_9_1
SMI4450X4006_2H_MA-_2_1 x 3
M94870_-_TOP_DIE_SUPERSET_CONFI
M94870_-_DIE_2_1
M94870_-_STIFFENER_KIZ_2_1
M91657_BTM_FID_METAL_PADS_1_2_A
M91657_BGA_SRO_1_8_ASM_2_ASM_1
M91657_BTM_FID_SRO_1_8_ASM_2_AS
M91657_BTM_METAL_PADS_1_2_ASM_2
BOSS-EXTRUDE1_2_-545486_2_1
M91657_PKG_OUTLINE_173_2_1
BOSS-EXTRUDE1_2_-236318_2_1
M91657_CAVITY_ASM_2_ASM_1
M94870_-_DRAM_SAMSUNG_16GB_2_1 x 2
M94870_-_MARK_KIZ_2_1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
