LattePandaTeam/LattePanda-Mu-Ultra/Mechanicals/LattePanda Mu Ultra Dimension Drawing.dxf

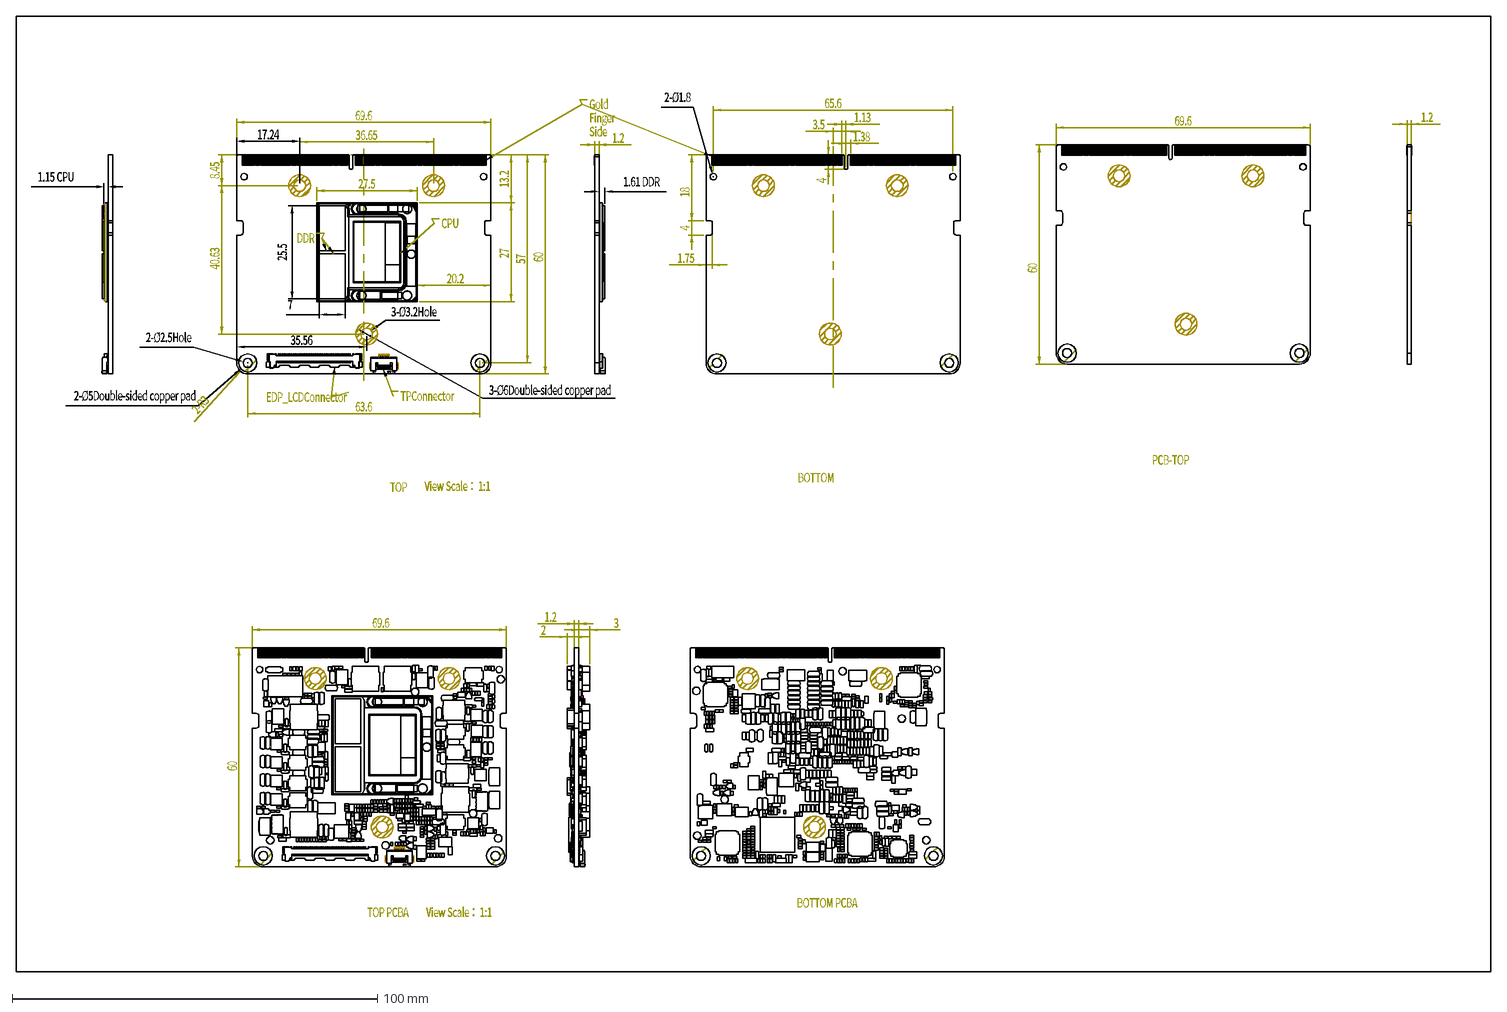
[picture p5: CAD file, 2026-08-21]
Mechanicals/LattePanda Mu Ultra Dimension Drawing.dxf
2-Ø5Double-sided copper pad
2-Ø2.5Hole
2-R3
3-Ø3.2Hole
3-Ø6Double-sided copper pad
69.6
36.65
40.63
63.6
57
8.45
13.2
27
27.5
20.2
1.2
18
4
1.75
65.6
3.5
1.13
1.38
2-Ø1.8
60
3
2
Gold Finger Side
TOP
BOTTOM
PCB-TOP
EDP_LCDConnector
TPConnector
View Scale： 1:1
TOP PCBA
BOTTOM PCBA
1.15 CPU
1.61 DDR
25.5
7
CPU
DDR
17.24
35.56
