LattePandaTeam/LattePanda-Mu-Ultra/Mechanicals/LattePanda Mu Ultra Dimension Drawing.pdf

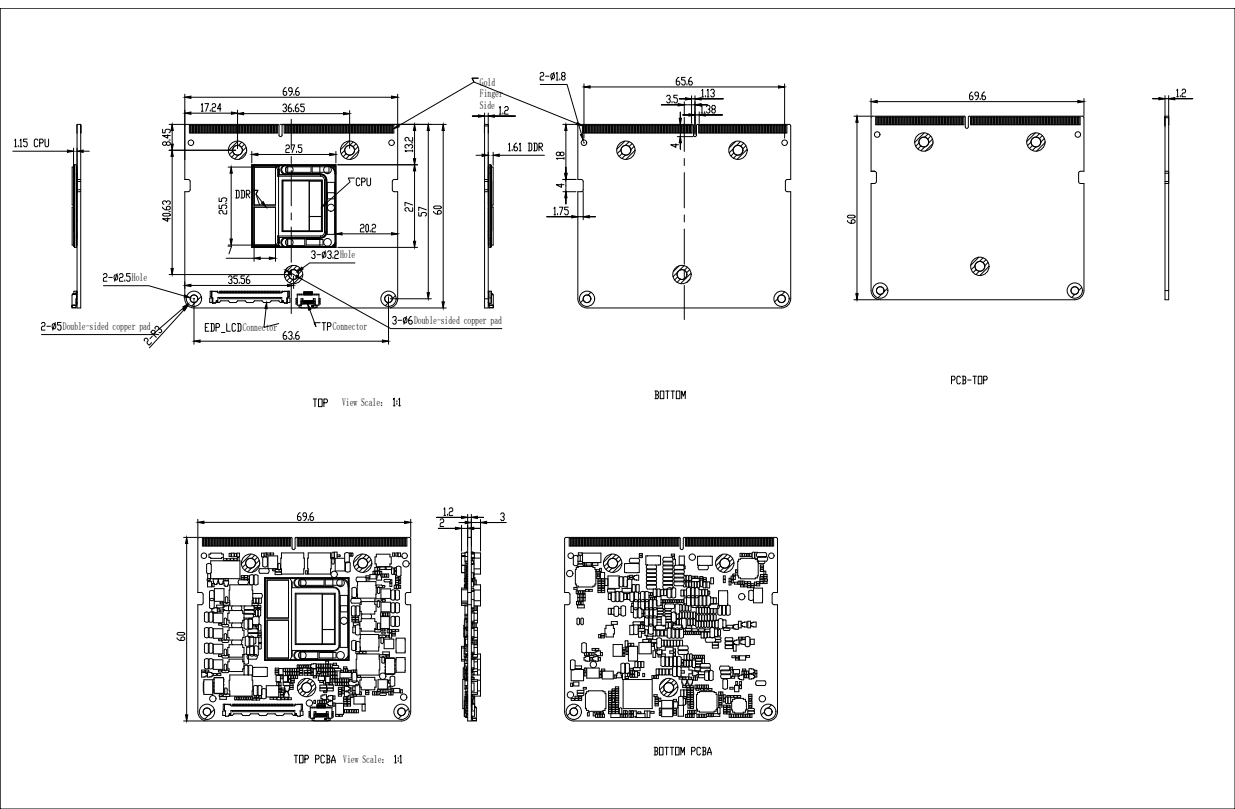
[picture p6: page 1]
Double-sided copper pad Hole; Hole; Double-sided copper pad Gold Finger Side Connector; Connector View Scale： View Scale：
