LattePandaTeam/LattePanda-Mu-Ultra/(commit log)

2026-08-21 Initial commit of repository files
    [LattePanda Mu Ultra 3D Model.stp, LattePanda Mu Ultra Dimension Drawing.dxf, LattePanda_Mu_Ultra_Edge_Connector_Pinout.xlsx]
2026-08-31 update pinout and readme
    [LattePanda_Mu_Ultra_Edge_Connector_Pinout.xlsx, LattePanda_Mu_and_Mu_Ultra_Pinout_Comparison.xlsx]
2026-09-06 add cooling fan's 3D model
    [FIT1049 LattePanda Mu Ultra Active Cooler.stp]
